gregelectric/nixie_tube_clock/hardware/SputnixD_ISS6.xls

REV D ISS 6
Count | ComponentName | RefDes | PatternName | Value | Description | Part Number | Distributor | Part Number | Price | Ext. Price |  | Digikey | Other
1 | 7805-TO-263 | U1 | TO-263-3 |  | C REGULATOR POSITIVE 5V TO-263 | LM340S-5.0 | Digikey | LM340S-5.0-ND | $2.06 | $2.06 | y
1 | AT90S8515-QFP | U5 | QFP44 |  | IC AVR MCU 8K 16MHZ IND 44-TQFP | ATMEGA8515-16AI | Digikey | ATMEGA8515-16AI-ND | $6.40 | $6.40 | y
1 | BUZZER | Z1 | BUZZER |  | BUZZER PIEZO 12VDC 13.7MM PCMNT | CEP-2242 | Digikey | 102-1115-ND | $3.28 | $3.28 | y
18 | CAP0805 | C1 | RC0805 | 0.1uF | CAP CER .1UF 16V 10% X7R 0805 | GRM219R71C104KA01D | Digikey | 490-1683-1-ND | $0.11 | $1.98 | y
 | CAP0805 | C2 | RC0805 | 0.1uF |  |  |  |  |  | $0.00
 | CAP0805 | C3 | RC0805 | 0.1uF |  |  |  |  |  | $0.00
 | CAP0805 | C7 | RC0805 | 0.1uF |  |  |  |  |  | $0.00
 | CAP0805 | C8 | RC0805 | 0.1uF |  |  |  |  |  | $0.00
 | CAP0805 | C11 | RC0805 | 0.1uF |  |  |  |  |  | $0.00
 | CAP0805 | C12 | RC0805 | 0.1uF |  |  |  |  |  | $0.00
 | CAP0805 | C14 | RC0805 | 0.1uF |  |  |  |  |  | $0.00
 | CAP0805 | C16 | RC0805 | 0.1uF |  |  |  |  |  | $0.00
 | CAP0805 | C17 | RC0805 | 0.1uF |  |  |  |  |  | $0.00
 | CAP0805 | C18 | RC0805 | 0.1uF |  |  |  |  |  | $0.00
 | CAP0805 | C19 | RC0805 | 0.1uF |  |  |  |  |  | $0.00
 | CAP0805 | C20 | RC0805 | 0.1uF |  |  |  |  |  | $0.00
 | CAP0805 | C21 | RC0805 | 0.1uF |  |  |  |  |  | $0.00
 | CAP0805 | C22 | RC0805 | 0.1uF |  |  |  |  |  | $0.00
 | CAP0805 | C23 | RC0805 | 0.1uF |  |  |  |  |  | $0.00
 | CAP0805 | C25 | RC0805 | 0.1uF
 | CAP0805 | C26 | RC0805 | 0.1uF |  |  |  |  |  | $0.00
3 | CAP0805 | C10 | RC0805 | OPT (33pF) | CAP 33PF 50V CERM CHIP 0805 SMD | ECJ-2VC1H330J | Digikey | PCC330CGCT-ND | $0.60 | $1.80 | na
 | CAP0805 | C15 | RC0805 | OPT (33pF) | CAP 33PF 50V CERM CHIP 0805 SMD | ECJ-2VC1H330J | Digikey | PCC330CGCT-ND | $0.60 | $0.00
1 | CAP_B | C13 | CAP_B | 33uF, 50V FC | CAP 33UF 50V ELECT FC RADIAL |  | Digikey |  |  | $0.00 | y
1 | CAP_C | C5 | CAP_C | 470uF 16V | CAP 470UF 16V ELECT RADIAL |  | Digikey |  |  | $0.00 | y
1 | CAP_D | C4 | CAP_D | 680uF 25V | CAP 680UF 25V ELECT FC RADIAL | EEUFC1E681 | Digikey | P10277-ND | $0.89 | $0.89 | y
1 | CAP_FS | C24 | CAP_FS | 0.1F, 5V | 0.1 FARAD GOLD CAP/1.0 FARAD GOLD CAP | EEC-F5R5U104/EEC-F5R5U105 | Digikey | P6952-ND | $2.89 | $2.89 | y
1 | CMMKP383 | C6 | CMMKP383 | 0.47uF 250V | CAP FILM MKP .47UF 250VDC 2% | 2222 418 74704 | Digikey | BC2172-ND | $1.55 | $1.55 | y
1 | CRYSTAL_SMT | XTAL1 | CRYSTAL_SMT | OPT (8.00MHz) | CRYSTAL 8.00MHZ 18PF SMD | ECS-80-18-5P-TR | Digikey | XC681CT-ND | $0.91 | $0.91 | na
3 | DBAV99 | D2 | SOT23_123 |  | DIODE SW DBL 75V 215MA HS SOT23 | BAV99 T/R | Digikey | 568-1624-1-ND | $0.10 | $0.30 | y
 | DBAV99 | D3 | SOT23_123 |  |  |  |  |  |  | $0.00
 | DBAV99 | D5 | SOT23_123 |  |  |  |  |  |  | $0.00
1 | DF04 | BR1 | DF04 |  | RECT BRIDGE GPP 400V 1A DF-M | DF04M | Digikey | DF04MDI-ND | $0.74 | $0.74 | n | DF04MDI-ND
1 | DIODE_SMB | D4 | SMB | MURS140 | DIODE ULTRA FAST 1A 400V SMB | MURS140T3 | Digikey | MURS140T3OSCT-ND | $0.43 | $0.43 | y
1 | DS1302 | U15 | SO-8 | DS1302Z | IC TIMEKEEPER T-CHARGE 8-SOIC | DS1302Z | Digikey | DS1302Z-ND | $4.11 | $4.11 | n | DS1302Z+CT-ND
1 | DSMCJ30A | D1 | DO-214AD | SMCJ12ADICT | TVS UNI-DIR 12V 1500W SMC | SMCJ12A-13 | Digikey | SMCJ12ADICT-ND | $1.55 | $1.55 | y
1 | G5V-1 | K1 | G5V-1 | {Value} | RELAY SPDT 1A 5V 167 OHM COIL | G5V-1-DC5 | Digikey | Z773-ND | $2.89 | $2.89 | na
1 | J25MM | J1 | J25MM | {Value} |  |  |  |  |  | $0.00 | na
1 | J35MM | J2 | J35MM |  |  |  |  |  |  | $0.00 | na
1 | J311550 | J3 | J311550 | {Value} | CONN POWER JACK 2.1MM | PJ-002A/PJ-006A | Digikey | CP-002A-ND/CP-006A-ND | $0.47 | $0.47 | y
1 | JHDR1X2 | J5 | JP1X2 |  |  |  |  |  |  | $0.00 | na
1 | JHDR2X3 | J6 | JP2X3 | OPT |  |  |  |  |  | $0.00 | na
1 | JMOL1X3 | J4 | JMOL1X3 |  | CONN HEADER 3POS .100 VERT GOLD | 22-11-2032 | Digikey | WM2701-ND | $1.24 | $1.24 | na
1 | LED0805 | LD1 | RC0805 | {Value} |  |  | Digikey |  |  | $0.00 | y
1 | MAX809 | U3 | SOT23_123 |  | IC MPU SUPERVISORY 4.0V SOT23 | MAX809JTR | Digikey | MAX809JTROSCT-ND | $0.79 | $0.79 | y
4 | NEON | NE1 | NEON | A9A | Chicago Miniature Neon Base Wire Terminal T-2 65VAC .7mA NE-2E |  | Mouser | 606-A9A | $0.34 | $1.36 | y
 | NEON | NE2 | NEON | A9A |  |  |  |  |  | $0.00
 | NEON | NE3 | NEON | A9A |  |  |  |  |  | $0.00
 | NEON | NE4 | NEON | A9A |  |  |  |  |  | $0.00
6 | NIXIE_IN-12B_S | N1 | NIXIE_IN-12B_S |  | Nixie Tube | IN-12B | Ebay | IN-12B | $5.00 | $30.00 | y
 | NIXIE_IN-12B_S | N2 | NIXIE_IN-12B_S |  |  |  |  |  |  | $0.00
 | NIXIE_IN-12B_S | N3 | NIXIE_IN-12B_S |  |  |  |  |  |  | $0.00
 | NIXIE_IN-12B_S | N4 | NIXIE_IN-12B_S |  |  |  |  |  |  | $0.00
 | NIXIE_IN-12B_S | N5 | NIXIE_IN-12B_S |  |  |  |  |  |  | $0.00
 | NIXIE_IN-12B_S | N6 | NIXIE_IN-12B_S |  |  |  |  |  |  | $0.00
3 | PB | S1 | PB |  | SWITCH TACT 6MM H=13MM 160GF | TL1105DF160Q | Digikey | EG1865-ND | $0.37 | $1.11 | na
 | PB | S2 | PB |  |  |  |  |  |  | $0.00
 | PB | S3 | PB |  |  |  |  |  |  | $0.00
1 | PHOTOCELL | R6 | PHOTOCELL | 20K | PHOTOCELL 9K-20K OHM 4.20MM | PDV-P9002 | Digikey | PDV-P9002-ND | $2.09 | $2.09 | y
1 | PNA4612M00XD | U2 | PNA4611XD |  | PHOTO IC INFRARED 38.0KHZ W/HLDR | PNA4612M00XD | Digikey | PNA4612M00XD-ND | $1.77 | $1.77 | y
1 | POLYSWITCH | RT1 | POLYSWITCH | RXE065 | POLYSWITCH RXE SERIES 0.65A HOLD |  | Digikey | RXE065-ND | $0.58 | $0.58 | y
1 | QIRF634S | Q4 | D2PAK |  | MOSFET N-CH 250V 8.1A D2PAK | IRF634S | Digikey | IRF634S-ND | $1.59 | $1.59 | n | IRF634STRRPBFCT-ND
4 | QMMBT3904 | Q1 | SOT23_123 |  | TRANSISTOR NPN GP 40V SOT23 | MMBT3904-TP | Digikey | MMBT3904TPMSCT-ND | $0.10 | $0.40 | y
 | QMMBT3904 | Q2 | SOT23_123 |  |  |  |  |  |  | $0.00
 | QMMBT3904 | Q3 | SOT23_123 |  |  |  |  |  |  | $0.00
 | QMMBT3904 | Q5 | SOT23_123 |  |  |  |  |  |  | $0.00
64 | QMMBTA42 | Q6 | SOT23_123 |  | TRANSISTOR HI VOLT NPN SOT-23 | MMBTA42 | Digikey | MMBTA42FSCT-ND | $0.19 | $12.16 | n | MMBTA42LT3GOSCT-ND
 | QMMBTA42 | Q7 | SOT23_123 |  |  |  |  |  |  | $0.00
 | QMMBTA42 | Q8 | SOT23_123 |  |  |  |  |  |  | $0.00
 | QMMBTA42 | Q9 | SOT23_123 |  |  |  |  |  |  | $0.00
 | QMMBTA42 | Q10 | SOT23_123 |  |  |  |  |  |  | $0.00
 | QMMBTA42 | Q11 | SOT23_123 |  |  |  |  |  |  | $0.00
 | QMMBTA42 | Q12 | SOT23_123 |  |  |  |  |  |  | $0.00
 | QMMBTA42 | Q13 | SOT23_123 |  |  |  |  |  |  | $0.00
 | QMMBTA42 | Q14 | SOT23_123 |  |  |  |  |  |  | $0.00
 | QMMBTA42 | Q15 | SOT23_123 |  |  |  |  |  |  | $0.00
 | QMMBTA42 | Q16 | SOT23_123 |  |  |  |  |  |  | $0.00
 | QMMBTA42 | Q17 | SOT23_123 |  |  |  |  |  |  | $0.00
 | QMMBTA42 | Q18 | SOT23_123 |  |  |  |  |  |  | $0.00
 | QMMBTA42 | Q19 | SOT23_123 |  |  |  |  |  |  | $0.00
 | QMMBTA42 | Q20 | SOT23_123 |  |  |  |  |  |  | $0.00
 | QMMBTA42 | Q21 | SOT23_123 |  |  |  |  |  |  | $0.00
 | QMMBTA42 | Q22 | SOT23_123 |  |  |  |  |  |  | $0.00
 | QMMBTA42 | Q23 | SOT23_123 |  |  |  |  |  |  | $0.00
 | QMMBTA42 | Q24 | SOT23_123 |  |  |  |  |  |  | $0.00
 | QMMBTA42 | Q25 | SOT23_123 |  |  |  |  |  |  | $0.00
 | QMMBTA42 | Q26 | SOT23_123 |  |  |  |  |  |  | $0.00
 | QMMBTA42 | Q27 | SOT23_123 |  |  |  |  |  |  | $0.00
 | QMMBTA42 | Q28 | SOT23_123 |  |  |  |  |  |  | $0.00
 | QMMBTA42 | Q29 | SOT23_123 |  |  |  |  |  |  | $0.00
 | QMMBTA42 | Q30 | SOT23_123 |  |  |  |  |  |  | $0.00
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
 | RES2512 | R86 | RC2512 | 33K |  |  |  |  |  | $0.00
 | RES2512 | R89 | RC2512 | 33K |  |  |  |  |  | $0.00
 | RES2512 | R90 | RC2512 | 33K |  |  |  |  |  | $0.00
 | RES2512 | R93 | RC2512 | 33K |  |  |  |  |  | $0.00
 | RES2512 | R94 | RC2512 | 33K |  |  |  |  |  | $0.00
1 | RES2512 | R2 | RC2512 | 100R | RES 100 OHM 1W 5% 2512 SMD | ERJ-1TYJ101U | Digikey | PT100XCT-ND | $0.49 | $0.49 | na
4 | RES2512 | R87 | RC2512 | 160K | RES 160K OHM 1W 5% 2512 SMD | ERJ-1TYJ164U | Digikey | PT160KXCT-ND | $0.49 | $1.96 | y
 | RES2512 | R88 | RC2512 | 160K |  |  |  |  |  | $0.00
 | RES2512 | R91 | RC2512 | 160K |  |  |  |  |  | $0.00
 | RES2512 | R92 | RC2512 | 160K |  |  |  |  |  | $0.00
1 | TOROID_VERT | L1 | TOROID_VERT | 200uH | Magnetics Inc. C055044A2, 27 turns, 22 AWG |  | Digikey |  | $5.00 | $5.00 | y
1 | ULM74CIM-5 | U14 | SO-8 |  | IC SENSOR TEMP DIGITAL 8-SOIC | LM74CIM-5 | Digikey | LM74CIM-5-ND | $2.38 | $2.38 | na
1 | UMAX1771 | U4 | SO-8 |  | IC DC/DC CTRLR STEP-UP HE 8-SOIC | MAX1771CSA | Digikey | MAX1771CSA-ND | $6.06 | $6.06 | y
8 | UMC14094B | U6 | SO-16 |  | IC SHIFT REGSTR 8BIT CMOS 16SOIC | MC14094BDR2 | Digikey | MC14094BDR2OSCT-ND | $0.52 | $4.16 | y
 | UMC14094B | U7 | SO-16 |  |  |  |  |  |  | $0.00
 | UMC14094B | U8 | SO-16 |  |  |  |  |  |  | $0.00
 | UMC14094B | U9 | SO-16 |  |  |  |  |  |  | $0.00
 | UMC14094B | U10 | SO-16 |  |  |  |  |  |  | $0.00
 | UMC14094B | U11 | SO-16 |  |  |  |  |  |  | $0.00
 | UMC14094B | U12 | SO-16 |  |  |  |  |  |  | $0.00
 | UMC14094B | U13 | SO-16 |  |  |  |  |  |  | $0.00
1 | XTAL_RTC | XTAL2 | XTAL_RTC | 32.768KHz, 6pF |  | CFS206-32.768KDZB-UB | Digikey | 300-8301-ND | $0.35 | $0.35 | y
 |  |  |  |  |  |  |  |  |  | $0.00
 |  |  |  |  |  |  |  |  |  | $0.00
Items Not Found In Schematic BOM
Count |  |  |  |  | Description | Part Number | Distributor | Part Number | Price
1 |  |  |  |  | printed circuit board | clockC | PCB Vendor |  | $20.00 | $20.00 | y
1 |  |  |  |  | RCA Universal remote control | RCU403 | Canadian Tire |  | $15.00 | $15.00 | n |  | https://www.rcaaudiovideo.com/remotes/2-3-devices/?sku=rcu403
1 |  |  |  |  | universal input switching power supply, 12VDC 1A output, 90~264VAC/47~63Hz input, 2.1mm plug | DPS120100UPS-P5P | Digikey | T461-P5P-ND | $20.64 | $20.64 | y
8 |  |  |  |  | #6-32 SCREW PANHEAD PHILLIPS 6X3/8 |  | Digikey | 6X3/8 PHSMSPH | $0.24 | $1.92 | n
4 |  |  |  |  | STANDOFF RD 6-32THR .375" ALUM | 3486 | Digikey | 3486K-ND | $0.26 | $1.04 | n
72 |  |  |  |  | PIN RECPT .040/.050 DIA 0355 SER | 0355-0-15-01-0227100 | Digikey | ED5024-ND | $0.22 | $15.84 | n
4 |  |  |  |  | SPACER MOUNTS LED T1 3/4 .280" | 8320K | Digikey | 8320K-ND | $0.11 | $0.44 | n
1 |  |  |  |  | 20 inches of 22AWG plain enamel transformer wire |  |  |  |  | $0.00 | y
Serial Cable Assembly
3 |  |  |  |  | CONN TERM FEMALE 22-30AWG GOLD | 08-56-0110 | Digikey | WM1129-ND | $0.67 | $2.01 | na
1 |  |  |  |  | CABLE DB9M-DB9F 2M | AK131-2 | Digikey | AE1020-ND | $6.64 | $6.64 | na
1 |  |  |  |  | CONN HOUS 3POS .100 W/RAMP/RIB | 22-01-2035 | Digikey | 22-01-2035-ND | $0.50 | $0.50 | na
 |  |  |  |  |  |  |  |  | Total | $197.70
