gregelectric/nixie_tube_clock/mechanical/clock_block.SLDASM

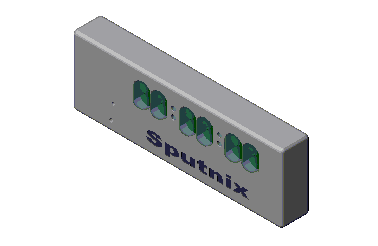
[picture p10: CAD file, 2020-12-03]
mechanical/clock_block.SLDASM
clock_block
clock
