gregelectric/nixie_tube_clock/(list of files, cad)

Other CAD files:
mechanical/Part1.SLDPRT
mechanical/clock.SLDPRT
mechanical/clock_block.SLDPRT
