gregelectric/nixie_tube_clock/hardware/BOT.pdf

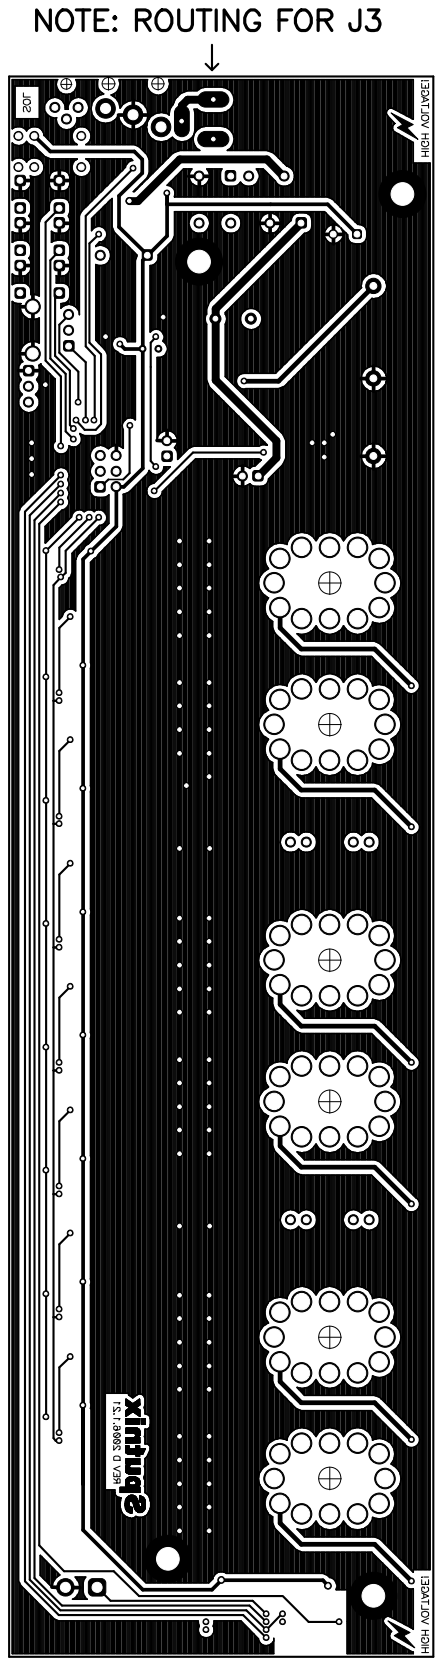
[picture p11: page 1]
