gregelectric/nixie_tube_clock/hardware/drill_stencil.pdf

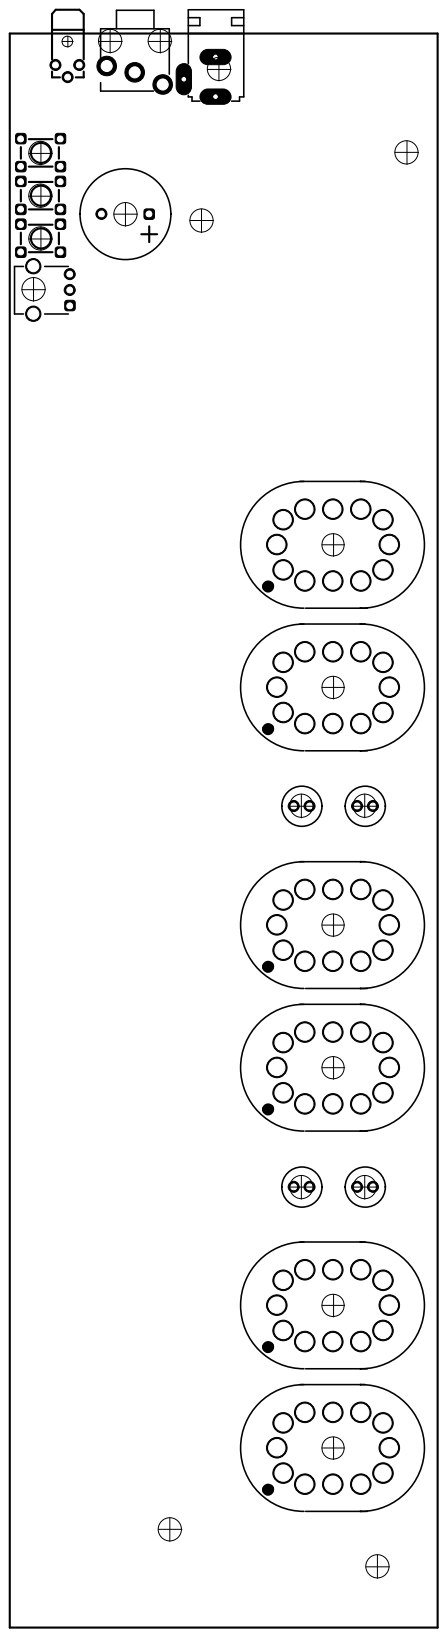
[picture p12: page 1]
