gregelectric/nixie_tube_clock/hardware/SLK.pdf

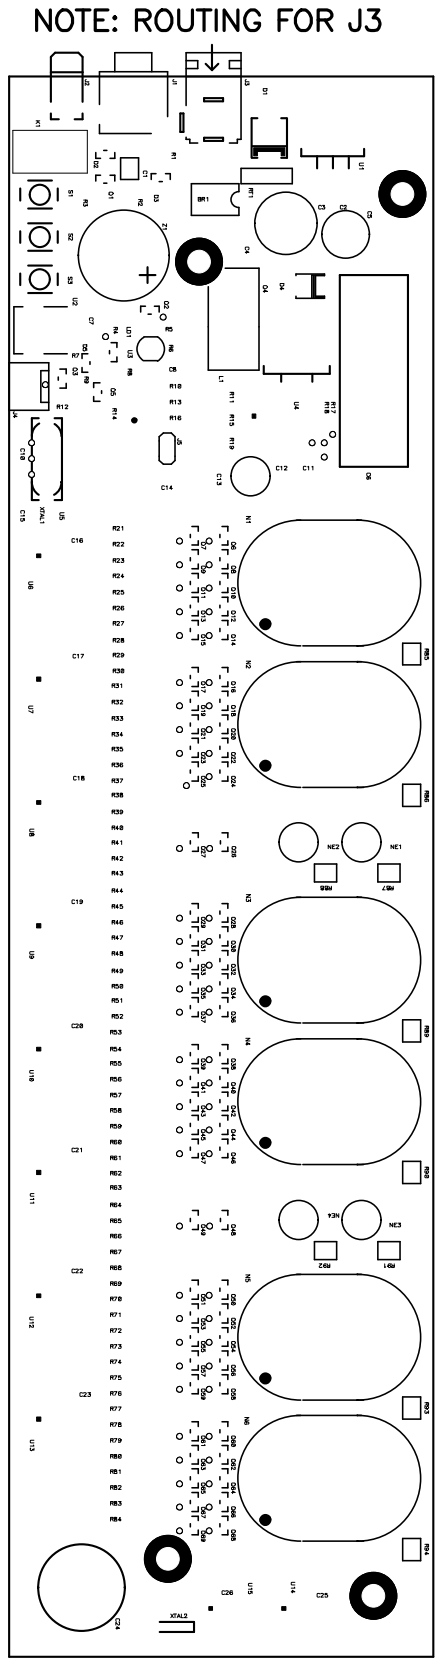
[picture p13: page 1]
