gregelectric/nixie_tube_clock/hardware/TOP.pdf

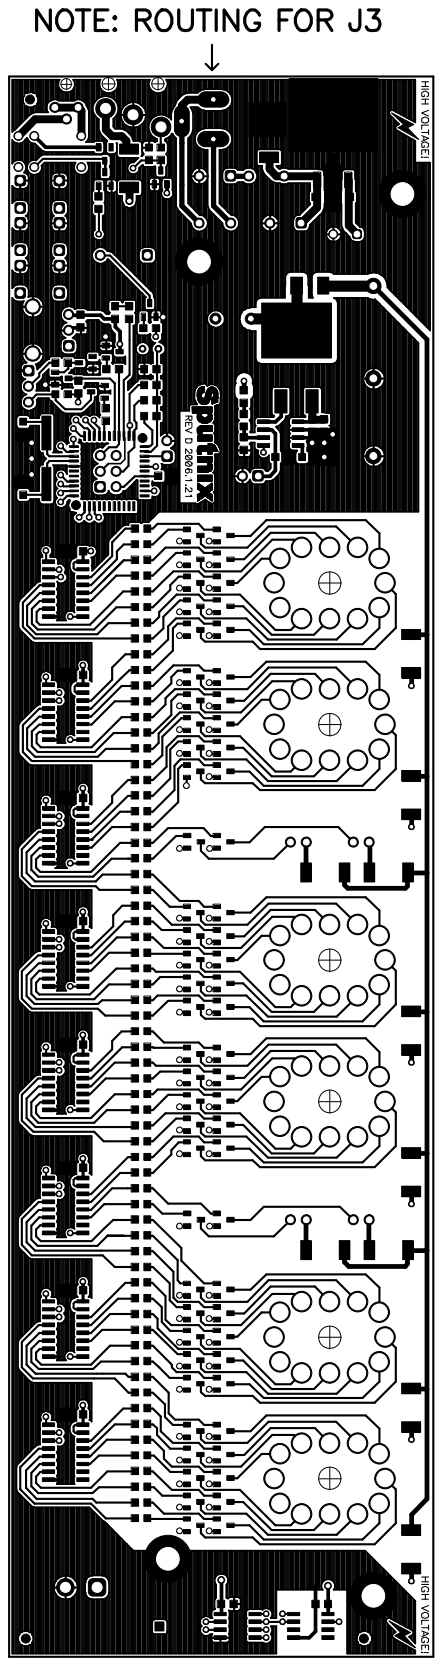
[picture p14: page 1]
