gregelectric/nixie_tube_clock/hardware/SputnixD_dim.pdf

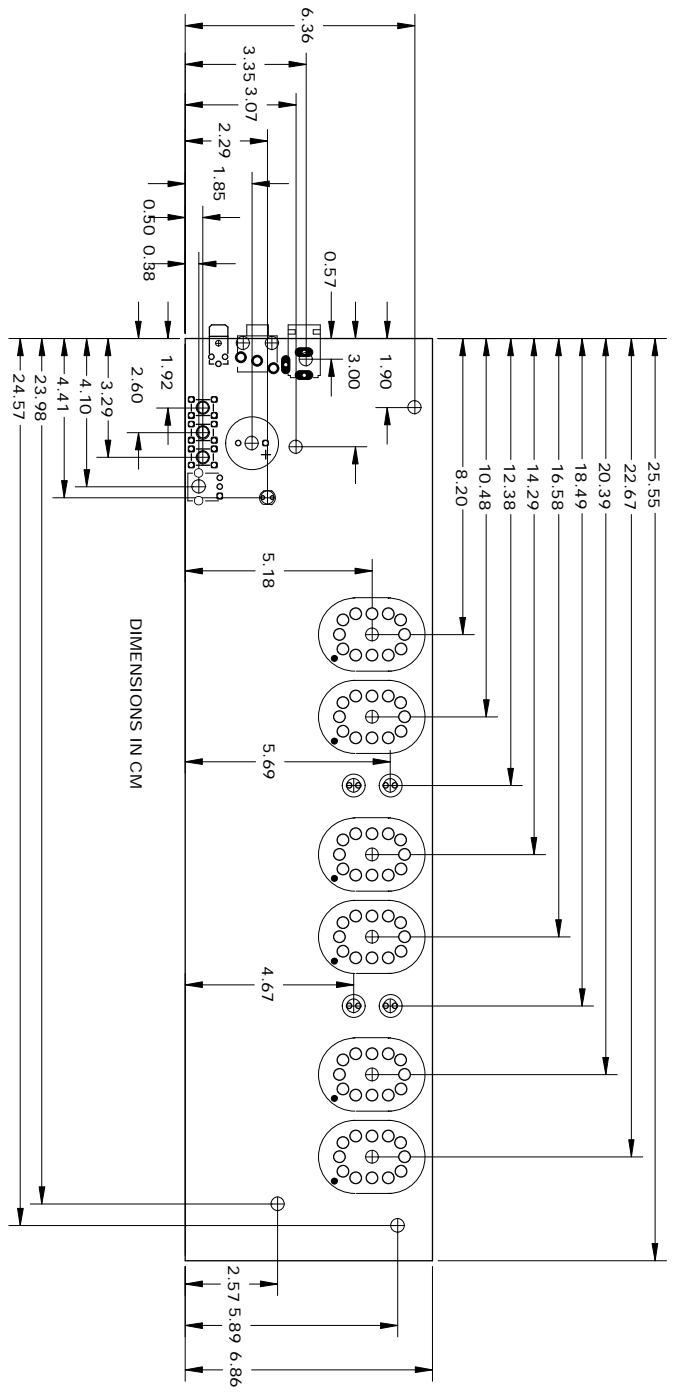
[picture p15: page 1]

DIMENSIONS IN CM
