gregelectric/nixie_tube_clock/hardware/SputnixD.pdf

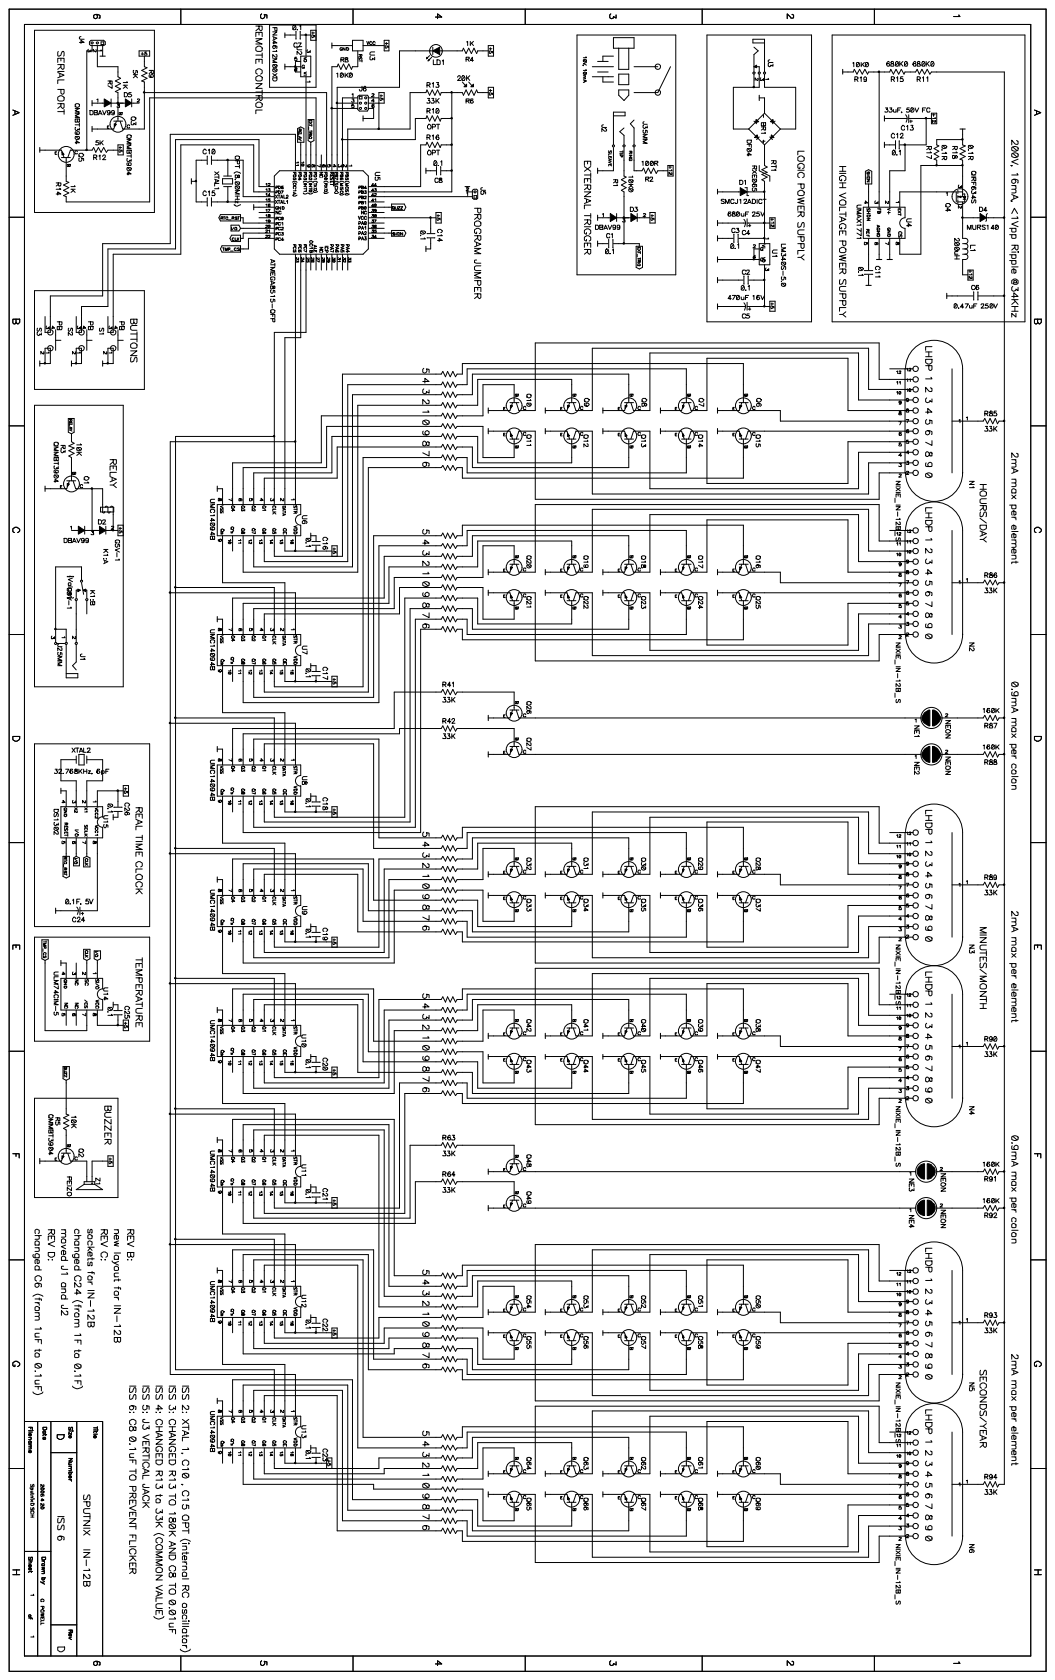
[picture p16: page 1]
